abstractfoundry/lumicube-boards/README.md

# lumicube-boards
PCB and firmware design files for some of the LumiCube components.

Note: this is just for reference. There are probably various broken links to directories along with other issues.

The firmware requires STMCubeIDE. The PCB files require KiCAD.
