abstractfoundry/lumicube-boards/PCBs/THP/THP.kicad_pcb

## KiCad design PCBs/THP/THP.kicad_pcb (2023-03-27)

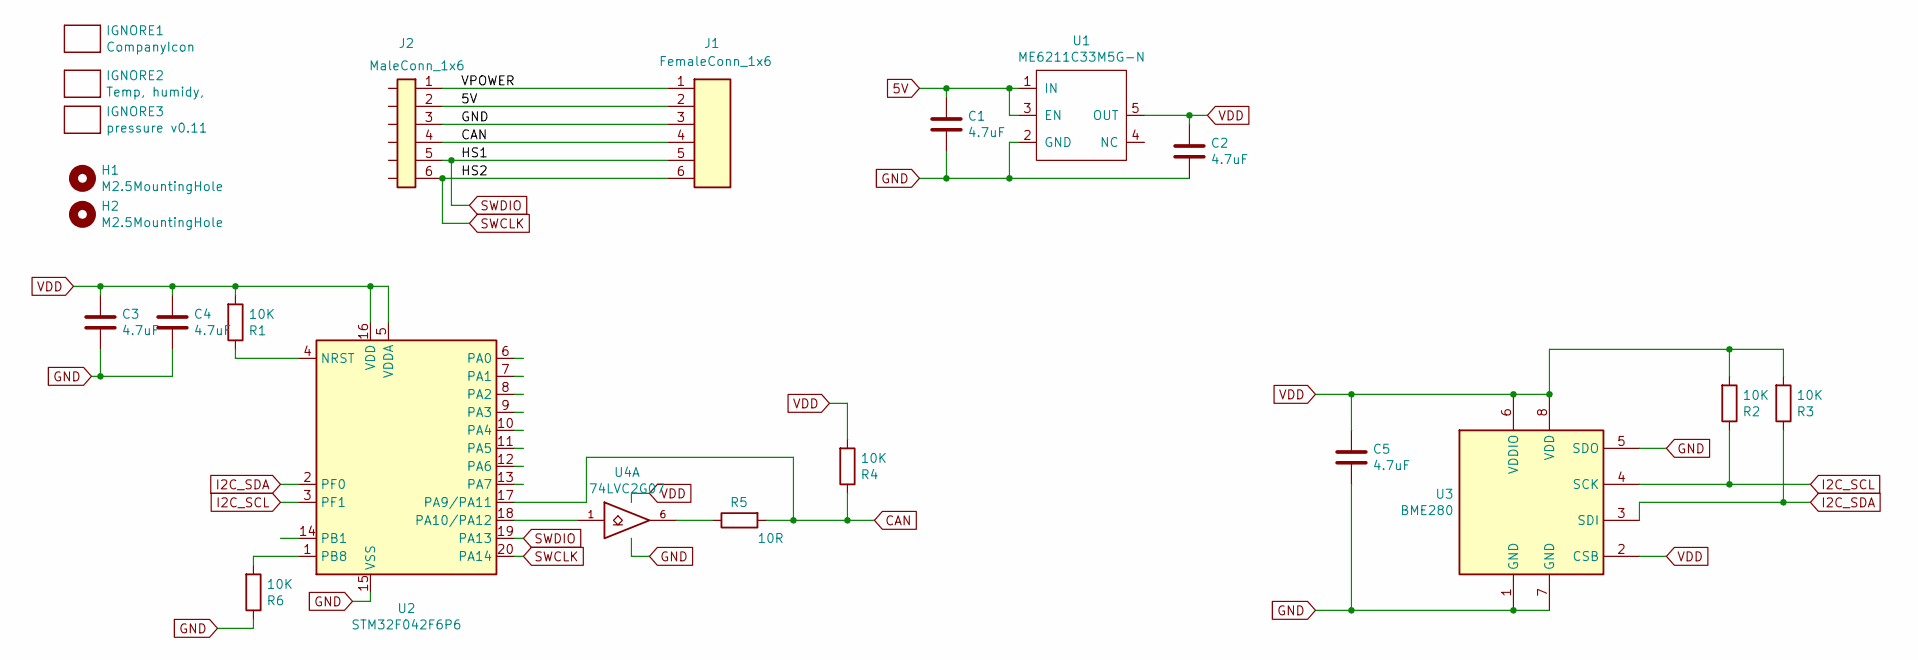
[picture p1: schematic THP.sch]

Parts:
C1, C2, C3, C4, C5: 4.7uF; C_0402_1005Metric
H1, H2: M2.5MountingHole; MountingHole_2.7mm_M2.5_ISO7380
IGNORE1: CompanyIcon
IGNORE2: Temp, humidy,; BoardText
IGNORE3: pressure v0.11; BoardText
J1: FemaleConn_1x6; M22-6540642R; Manufacturer_Part_Number A2005HWR-S-6P-Y
J2: MaleConn_1x6; M22-5330605R; Manufacturer_Part_Number A2005WR-S-6P
R1, R2, R3, R4, R6: 10K; R_0402_1005Metric
R5: 10R; R_0402_1005Metric
U1: ME6211C33M5G-N; SOT-23-5
U2: STM32F042F6P6
U3: BME280; TempHumidyPressure_BME280; Manufacturer_Part_Number BME280
U4: 74LVC2G07; SOT-23-6

Connections:
5V: C1.1, J1.2, J2.2, U1.1 (IN), U1.3 (EN)
/VPOWER: J1.1, J2.1
CAN: J1.4, J2.4, R4.1, R5.2, U2.17 (PA9/PA11)
GND: C1.2, C2.2, C3.2, C4.2, C5.2, J1.3, J2.3, R6.1, U1.2 (GND), U2.15 (VSS), U3.1 (GND), U3.5 (SDO), U3.7 (GND), U4.2 (GND)
I2C_SCL: R2.1, U2.3 (PF1), U3.4 (SCK)
I2C_SDA: R3.1, U2.2 (PF0), U3.3 (SDI)
unnamed: R1.1, U2.4 (NRST)
unnamed: R5.1, U4.6
unnamed: R6.2, U2.1 (PB8)
unnamed: U2.18 (PA10/PA12), U4.1
SWCLK: J1.6, J2.6, U2.20 (PA14)
SWDIO: J1.5, J2.5, U2.19 (PA13)
VDD: C2.1, C3.1, C4.1, C5.1, R1.2, R2.2, R3.2, R4.2, U1.5 (OUT), U2.5 (VDDA), U2.16 (VDD), U3.2 (CSB), U3.6 (VDDIO), U3.8 (VDD), U4.5 (VCC)

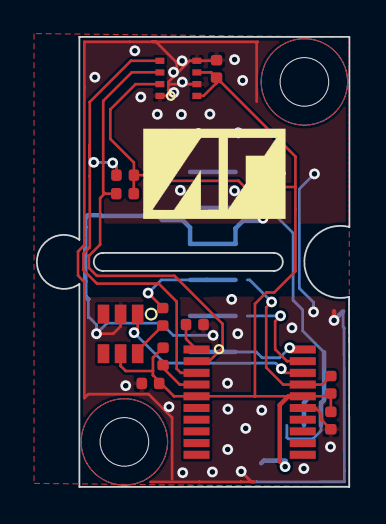
[picture p2: board THP.kicad_pcb from above]

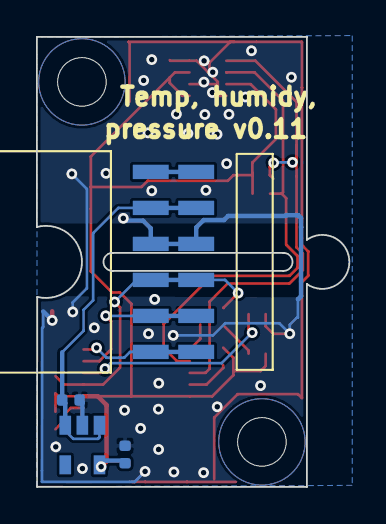
[picture p3: board THP.kicad_pcb from below]

Board: 2 copper layers, 17.4 x 25.0 mm, 22 parts (5 on the bottom side), 13 nets.
