abstractfoundry/lumicube-boards/PCBs/IMU/IMU.kicad_pcb

## KiCad design PCBs/IMU/IMU.kicad_pcb (2023-03-27)

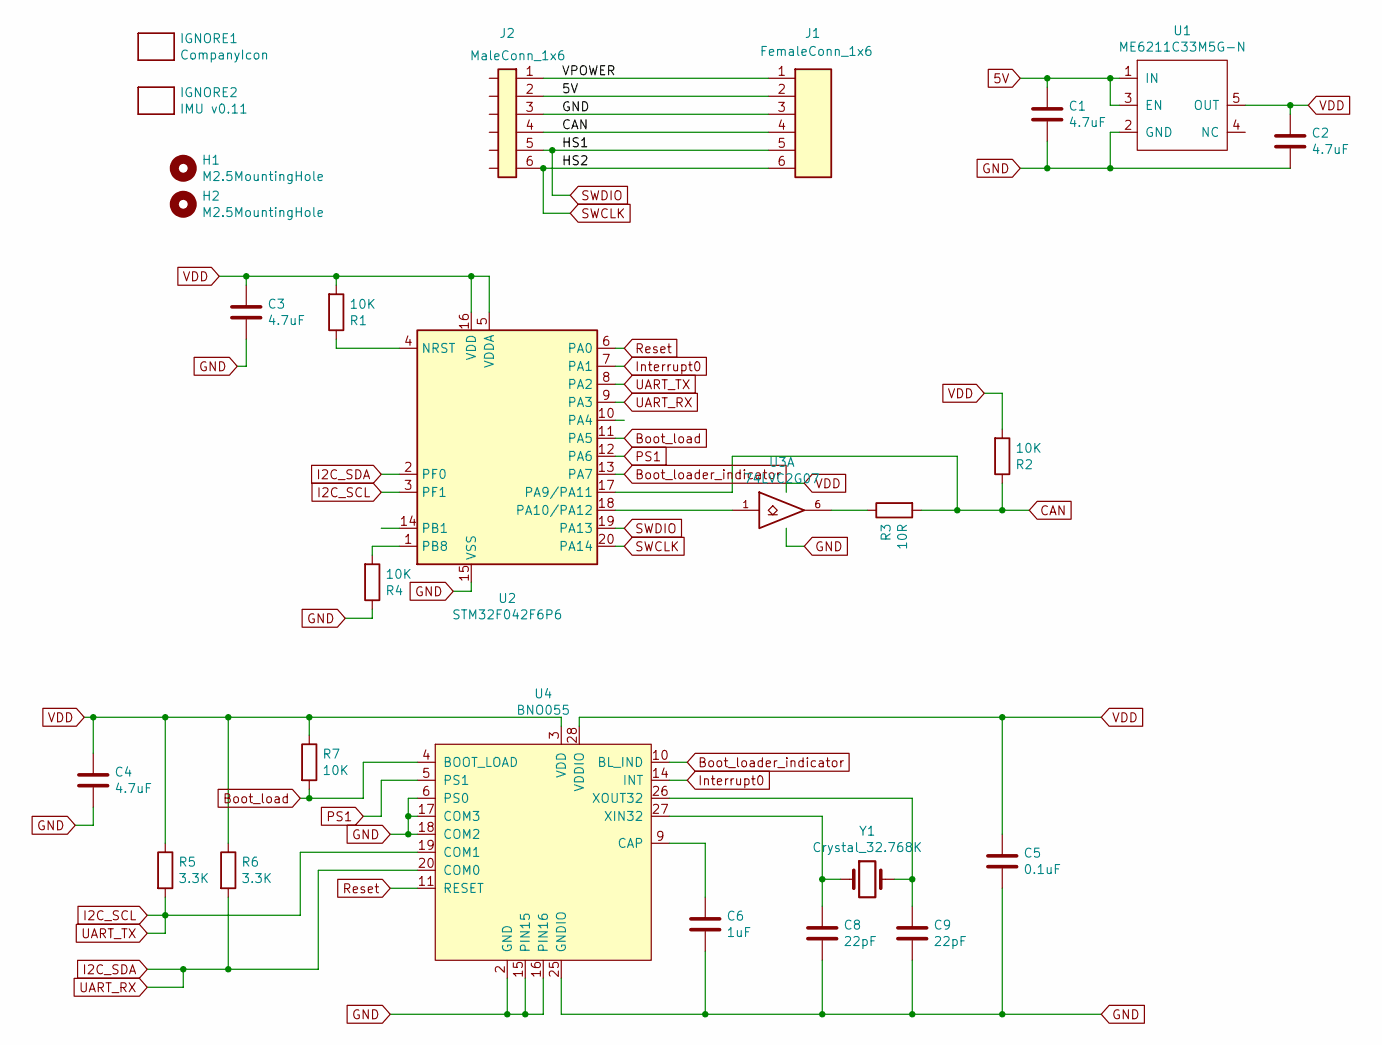
[picture p4: schematic IMU.sch]

Parts:
C1, C2, C3, C4: 4.7uF; C_0402_1005Metric
C5: 0.1uF; C_0402_1005Metric
C6: 1uF; C_0402_1005Metric
C8, C9: 22pF; C_0402_1005Metric
H1, H2: M2.5MountingHole; MountingHole_2.7mm_M2.5_ISO7380
IGNORE1: CompanyIcon
IGNORE2: IMU v0.11; BoardText
J1: FemaleConn_1x6; M22-6540642R; Manufacturer_Part_Number A2005HWR-S-6P-Y
J2: MaleConn_1x6; M22-5330605R; Manufacturer_Part_Number A2005WR-S-6P
R1, R2, R4, R7: 10K; R_0402_1005Metric
R3: 10R; R_0402_1005Metric
R5, R6: 3.3K; R_0402_1005Metric
U1: ME6211C33M5G-N; SOT-23-5
U2: STM32F042F6P6
U3: 74LVC2G07; SOT-23-6
U4: BNO055; IMU-BNO055; Manufacturer_Part_Number BNO055
Y1: Crystal_32.768K; Crystal_SMD_3215-2Pin_3.2x1.5mm

Connections:
5V: C1.1, J1.2, J2.2, U1.1 (IN), U1.3 (EN)
/VPOWER: J1.1, J2.1
Boot_load: R7.2, U2.11 (PA5), U4.4 (BOOT_LOAD)
Boot_loader_indicator: U2.13 (PA7), U4.10 (BL_IND)
CAN: J1.4, J2.4, R2.1, R3.2, U2.17 (PA9/PA11)
GND: C1.2, C2.2, C3.2, C4.2, C5.2, C6.2, C8.2, C9.2, J1.3, J2.3, R4.1, U1.2 (GND), U2.15 (VSS), U3.2 (GND), U4.2 (GND), U4.6 (PS0), U4.15 (PIN15), U4.16 (PIN16), U4.17 (COM3), U4.18 (COM2), U4.25 (GNDIO)
I2C_SCL: R5.2, U2.3 (PF1), U2.8 (PA2), U4.19 (COM1)
I2C_SDA: R6.2, U2.2 (PF0), U2.9 (PA3), U4.20 (COM0)
Interrupt0: U2.7 (PA1), U4.14 (INT)
unnamed: C6.1, U4.9 (CAP)
unnamed: C8.1, U4.27 (XIN32), Y1.1
unnamed: C9.1, U4.26 (XOUT32), Y1.2
unnamed: R1.1, U2.4 (NRST)
unnamed: R3.1, U3.6
unnamed: R4.2, U2.1 (PB8)
unnamed: U2.18 (PA10/PA12), U3.1
PS1: U2.12 (PA6), U4.5 (PS1)
Reset: U2.6 (PA0), U4.11 (RESET)
SWCLK: J1.6, J2.6, U2.20 (PA14)
SWDIO: J1.5, J2.5, U2.19 (PA13)
VDD: C2.1, C3.1, C4.1, C5.1, R1.2, R2.2, R5.1, R6.1, R7.1, U1.5 (OUT), U2.5 (VDDA), U2.16 (VDD), U3.5 (VCC), U4.3 (VDD), U4.28 (VDDIO)

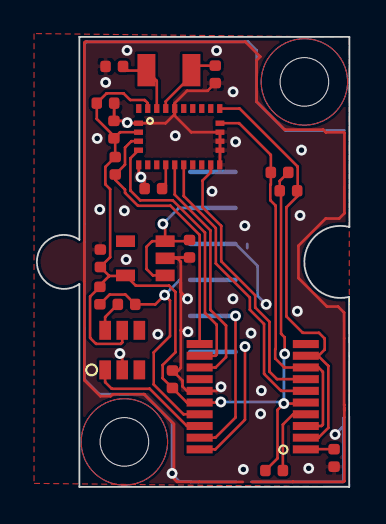
[picture p5: board IMU.kicad_pcb from above]

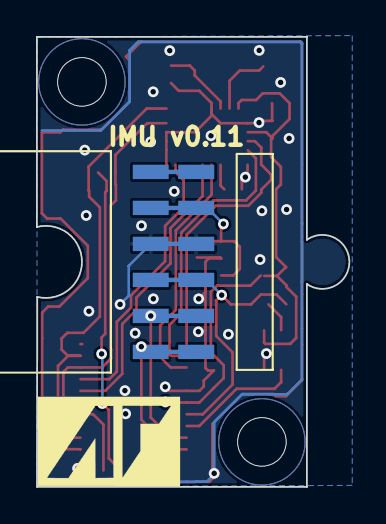
[picture p6: board IMU.kicad_pcb from below]

Board: 2 copper layers, 17.4 x 25.0 mm, 26 parts (3 on the bottom side), 21 nets.
