abstractfoundry/lumicube-boards/Firmware/IMU/IMU.ioc

Mcu.UserName=STM32F042F6Px
PA0.Signal=GPIO_Output
PA1.Signal=GPIO_Input
PA11.Signal=CAN_RX
PA12.Signal=CAN_TX
PA13.Signal=SYS_SWDIO
PA14.Signal=SYS_SWCLK
PA2.Signal=USART2_TX
PA3.Signal=USART2_RX
PA5.Signal=GPIO_Output
PA6.Signal=GPIO_Output
PA7.Signal=GPIO_Input
PF0-OSC_IN.Signal=I2C1_SDA
PF1-OSC_OUT.Signal=I2C1_SCL
